NurassylTileubekov/Mode-Locking-Detector/MLDS_G4.ioc

Mcu.UserName=STM32G474CEUx
PA13.Signal=SYS_JTMS-SWDIO
PA14.Signal=SYS_JTCK-SWCLK
PA6.Signal=ADC2_IN3
PA8.Signal=I2C2_SDA
PA9.Signal=I2C2_SCL
PB0.Signal=ADC1_IN15
PB3.GPIO_Label=USER_BUTTON
PB3.Signal=GPXTI3
PB6.Signal=USART1_TX
PB7.Signal=USART1_RX
PC10.GPIO_Label=LED_RED
PC10.Signal=GPIO_Output
PC11.GPIO_Label=LED_YELLOW
PC11.Signal=GPIO_Output
PF0-OSC_IN.Signal=RCC_OSC_IN
PF1-OSC_OUT.Signal=RCC_OSC_OUT
