NurassylTileubekov/Mode-Locking-Detector/Core/Inc/laser.h

// Inc/laser.h
#ifndef LASER_H
#define LASER_H

#include <stdint.h>
#include "CV.h"

// Firmware version
#define FIRMWARE_VERSION          0xF100
#define FLUSH_FLASH_ON_FW_UPDATE  0

// ML detection thresholds (mV). High threshold is scaled by saturation_percent.
#define ML_THRESHOLD_LOW_MV   300.0f
#define ML_THRESHOLD_HIGH_MV  3300.0f

#define CW_THRESHOLD_LOW_MV 350.0f
#define CW_THRESHOLD_HIGH_MV 3250.0f

// Defaults: target_window_ms, threshold_offset, saturation_percent
#define LASER_CONFIG_DEFAULT (laser_config_t){0xAA, FIRMWARE_VERSION, 0, 25, 0.05f, 0.9f, 0xBB}

// control byte bits
#define RESET_TO_DEFAULT_BIT    0b00000001U
#define START_ACQUIRING_BIT     0b00000010U
#define STOP_ACQUIRING_BIT      0b00000100U
#define REVERT_TO_PREV_BIT      0b00001000U
#define REQUEST_PARAM_BIT       0b00010000U
#define REQUEST_ERROR_BIT       0b00100000U
#define UPDATE_PARAM_BIT        0b01000000U

enum laser_status {
    LOW_SIGNAL,
    CW,
    UNSTABLE,
    MODE_LOCKED,
    SATURATED,
    INITIATING,
};
// Configuration received from PC
typedef struct __attribute__((packed)) {
    uint8_t frame_start;
    uint16_t firmware_version;
    uint8_t ctrl_byte;
    uint16_t target_window_ms;
    float threshold_offset;
    float saturation_percent;   // 0.0 - 1.0, scales the saturation thresholds
    uint8_t frame_end;
} laser_config_t;

// CW thresholds (mV) produced by calibration; stored in flash with the CV model.
typedef struct {
    float cw_threshold_low;
    float cw_saturation;
} cw_calibration_t;
#define CW_CALIBRATION_DEFAULT (cw_calibration_t){100.0f, 3200.0f}

// Combined calibration written to flash in a single page-erase.
typedef struct {
    cv_model_params_t cv;
    cw_calibration_t  cw;
    float mse;
    float r_squared;
} laser_calibration_t;

typedef struct {
    float ml_rms_mv;
    float cw_mv;
    float current_cv;
    float current_cv_threshold;
    enum laser_status status;
    uint8_t has_seen_cw;
} laser_state_t;

// Telemetry frame sent to PC
typedef struct __attribute__((packed)) {
    uint8_t frame_start;
    float ml_rms_mv;
    float cw_mv;
    float current_cv;
    float current_cv_threshold;
    uint8_t status;
    uint8_t frame_end;
} laser_frame_t;

// Coefficient of Determination and MSE sent to PC
typedef struct __attribute__((packed)) {
    uint8_t frame_start;
    float mse;
    float r_squared;
    uint8_t frame_end;
} laser_err_t;

void process_laser_logic(uint16_t* buf, uint16_t size, sliding_cv_t* scv, float* cv_threshold_lut, laser_config_t* config, cw_calibration_t* cal, uint16_t adc2_val, laser_state_t* state);

#endif // LASER_H
