NurassylTileubekov/Mode-Locking-Detector/(commit log)

2026-04-08 Added UART for data logging
2026-06-14 Update telemetry payload structure and visualization colors - Multiplex MCU config to Python GUI every 50 frames - Update STM32 main.c code to transmit config data over UART - Add CW plot to telemetr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
2026-06-14 Fix syntax error 3300f to 3300.0f in laser.c
    [laser.c]
2026-06-14 Fix python UI to handle the original 26-byte STM32 config format
2026-07-18 Add README with schematics/PCB/results, clean up repo
    - Add README.md documenting architecture, calibration, UART protocol,
    build/flash, with schematic, PCB, and results images under docs/images/
    - Ignore build/, .idea/, __pycache__/, and telemetry.py; untrack .idea/
    - Strip verbose comments down to occasional brief ones across
    laser/CV/fit and the main.c USER CODE sections
    - Add on-chip Levenberg-Marquardt curve fit (fit.c/fit.h) and HAL I2C drivers
    - Remove host-side telemetry.py from the repo (kept local for now)
2026-11-08 parameter values, MSE and R^2 are updated on request, instead of periodically, the user button is repurposed to clear the data saved to flash
